TranQuocLoc/co-sinh/Paper/kinematic_tracking.png

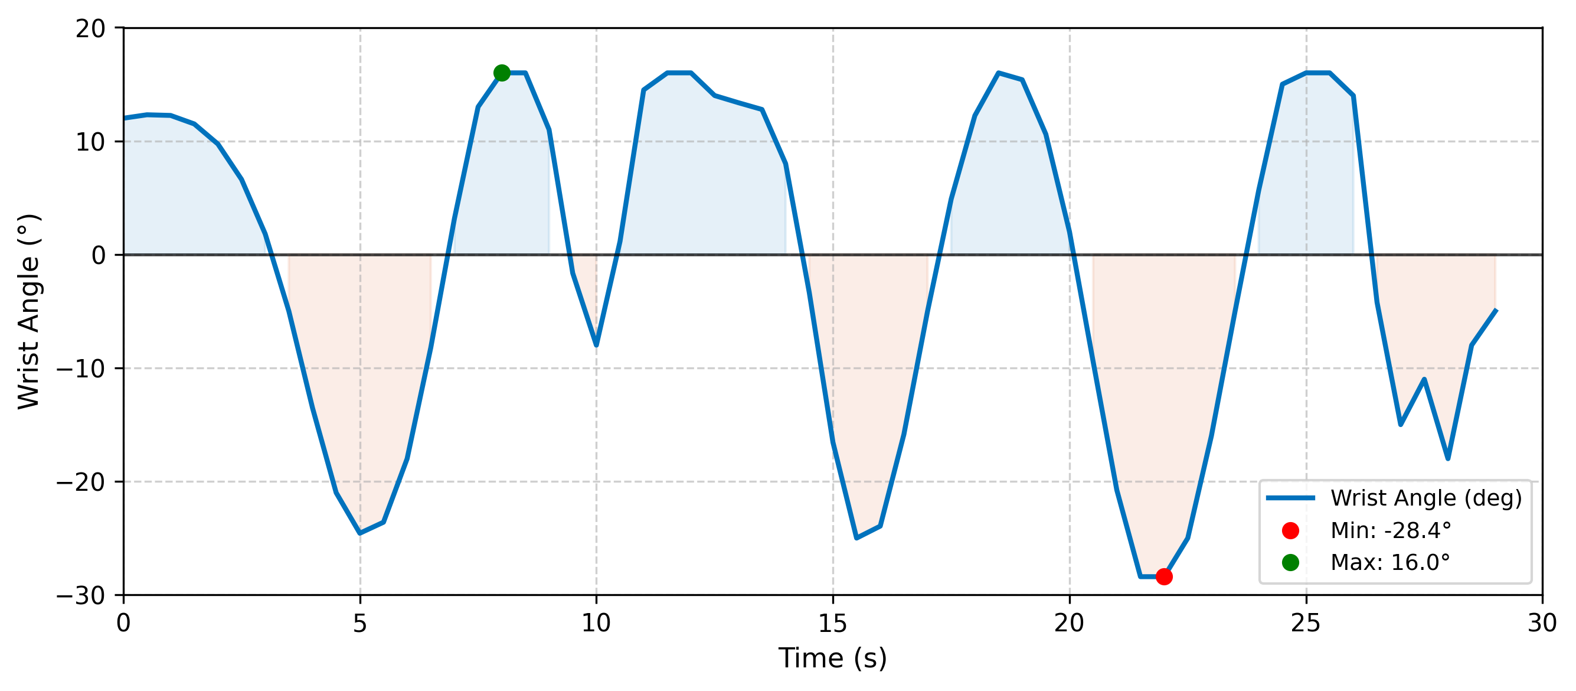
Paper/kinematic_tracking.png
