TranQuocLoc/co-sinh/thiết kế trục.png

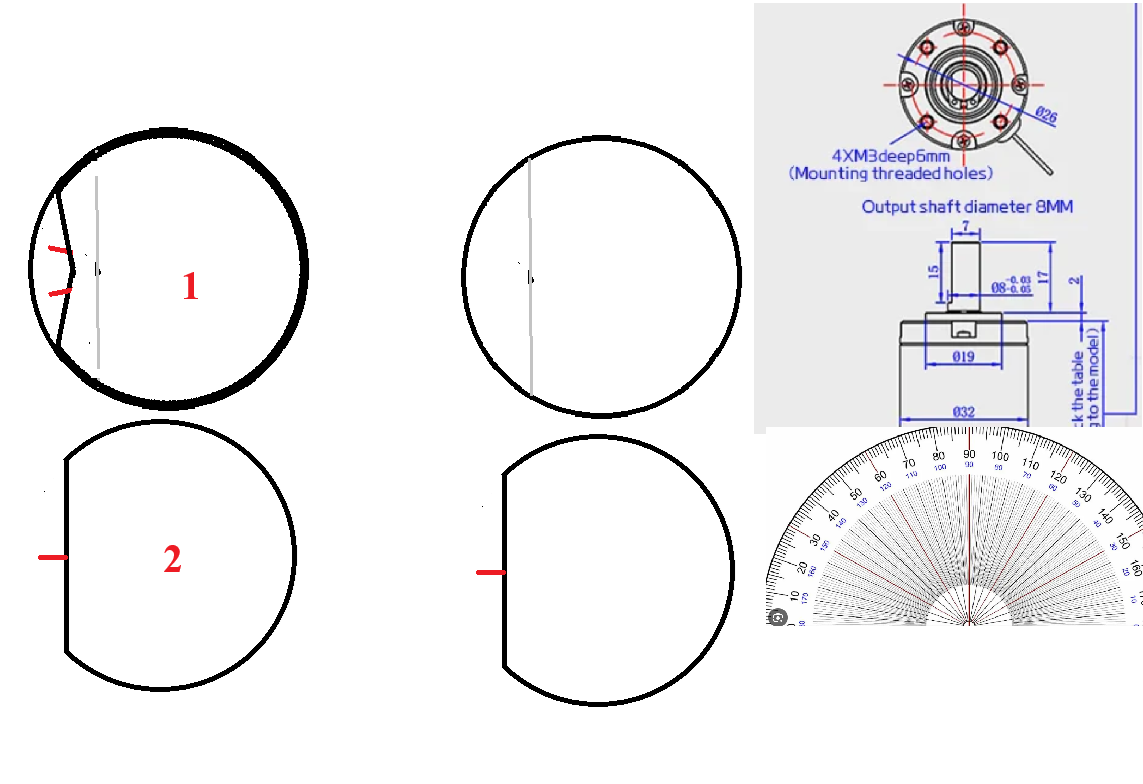
thiết kế trục.png
