TranQuocLoc/co-sinh/In3d/DO-DONG-CO-NEW.3mf

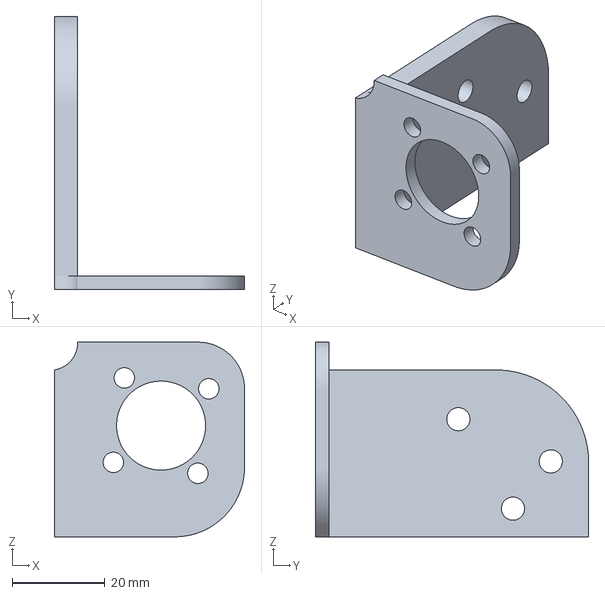
[picture p4: CAD file, 2026-05-07]
In3d/DO-DONG-CO-NEW.3mf
41.0 x 59.0 x 42.0 mm
