TranQuocLoc/co-sinh/In3d/Banh-rang-truc-be-FINAL (1).3mf

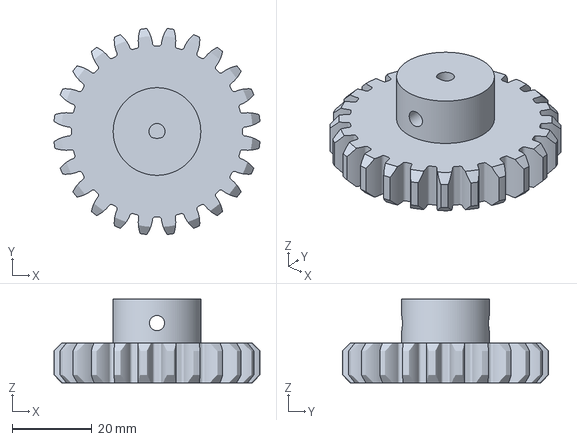
[picture p5: CAD file, 2026-05-07]
In3d/Banh-rang-truc-be-FINAL (1).3mf
51.7 x 51.7 x 21.0 mm
