TranQuocLoc/co-sinh/In3d/Banh-rang-MOTOR-NEW-FIX.3mf

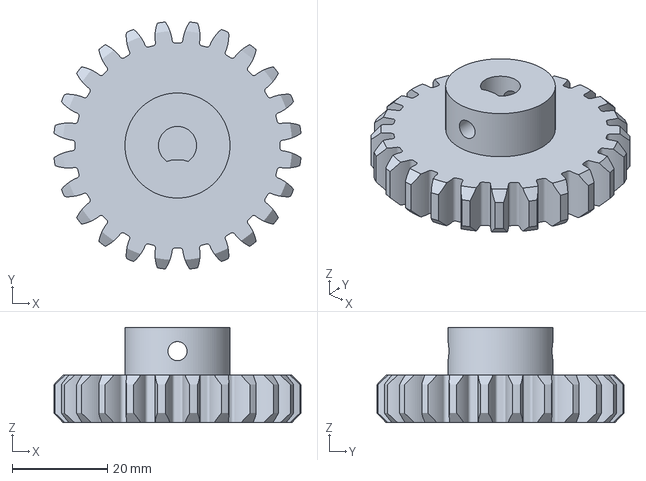
[picture p6: CAD file, 2026-05-07]
In3d/Banh-rang-MOTOR-NEW-FIX.3mf
51.7 x 51.7 x 20.0 mm
